tymur-l/SnakeGame_FPGA/README.md

# SnakeGame_FPGA
A snake game implemented in Verilog to run on FPGA

## [Article about this project](https://habr.com/post/431226/)
