tymur-l/SnakeGame_FPGA/text/Design.pdf

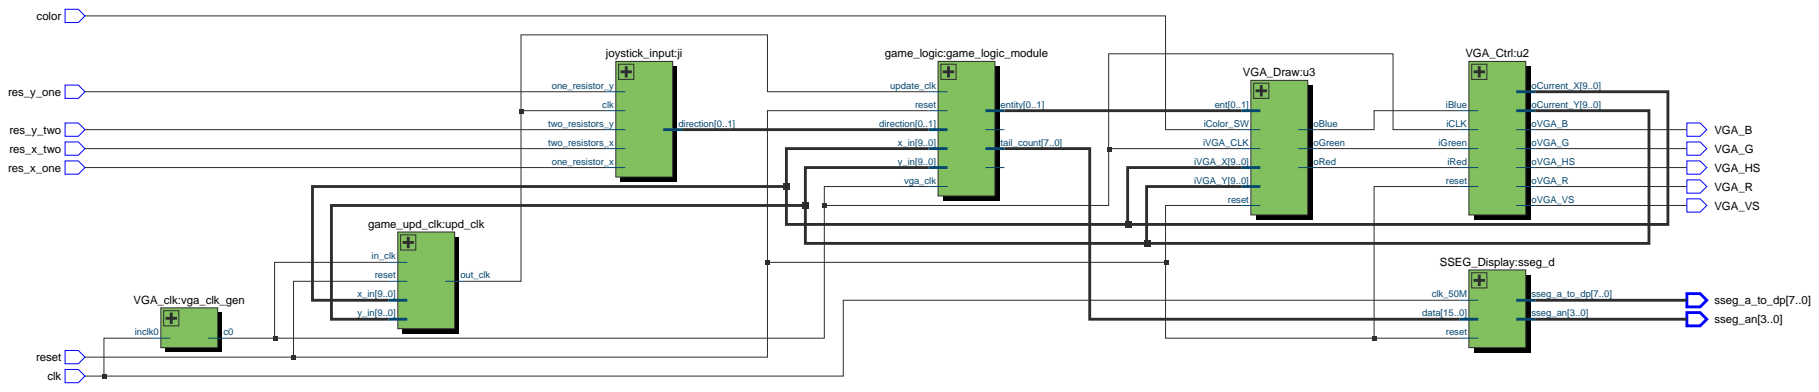
[picture p5: figure]
game_logic:game_logic_module; reset; update_clk; vga_clk; direction[0..1]; entity[0..1]; tail_count[7..0]; joystick_input:ji; clk; one_resistor_x; one_resistor_y; two_resistors_x; two_resistors_y; VGA_B; VGA_Ctrl:u2; iBlue; iCLK; iGreen; iRed; oVGA_B; oVGA_G; oVGA_HS; oVGA_R; oVGA_VS; oCurrent_X[9..0]; oCurrent_Y[9..0]; VGA_Draw:u3; iColor_SW; iVGA_CLK; iVGA_X[9..0]; iVGA_Y[9..0]; ent[0..1]; oBlue; oGreen; oRed; VGA_G VGA_HS VGA_R VGA_VS; VGA_clk:vga_clk_gen; inclk0; game_upd_clk:upd_clk; in_clk; out_clk; color; SSEG_Display:sseg_d; clk_50M; data[15..0]; sseg_a_to_dp[7..0]; sseg_an[3..0]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
