tymur-l/SnakeGame_FPGA/(commit log)

2018-10-28 Driving VGA controller with an entity to draw
    At this stage there is a static output to the screen and basic outline of the game logic module.
2018-10-29 input via buttons on board for testing
2018-10-29 fix for buttons (output via output reg)
2018-11-05 Snake head left & top movement
    TODOs:
    1) There is a bug with right and down directions.
    2) Create separate sprites for debug and use them
    3) Come up with a solution for boundaries
    [SnakeGame.v, VGA_Pattern.v, game_logic.v]
2018-11-05 Fixed problem with right and down directions & boundaries
    [SnakeGame.v, VGA_Pattern.v, game_logic.v]
2018-11-08 Snake tail, collision logic
    TODO: apple generation
    BUG: Snake dies, if eats at coordinates (0, 0)
    [LFSR.v, SnakeGame.v, game_logic.v]
2018-11-08 Fixed bug with (0; 0) coordinate death
    [game_logic.v]
2018-11-18 Changed the picture for ADC
